jonas-schievink/thesis/meshes/kurt_wheel_outdoor.stl

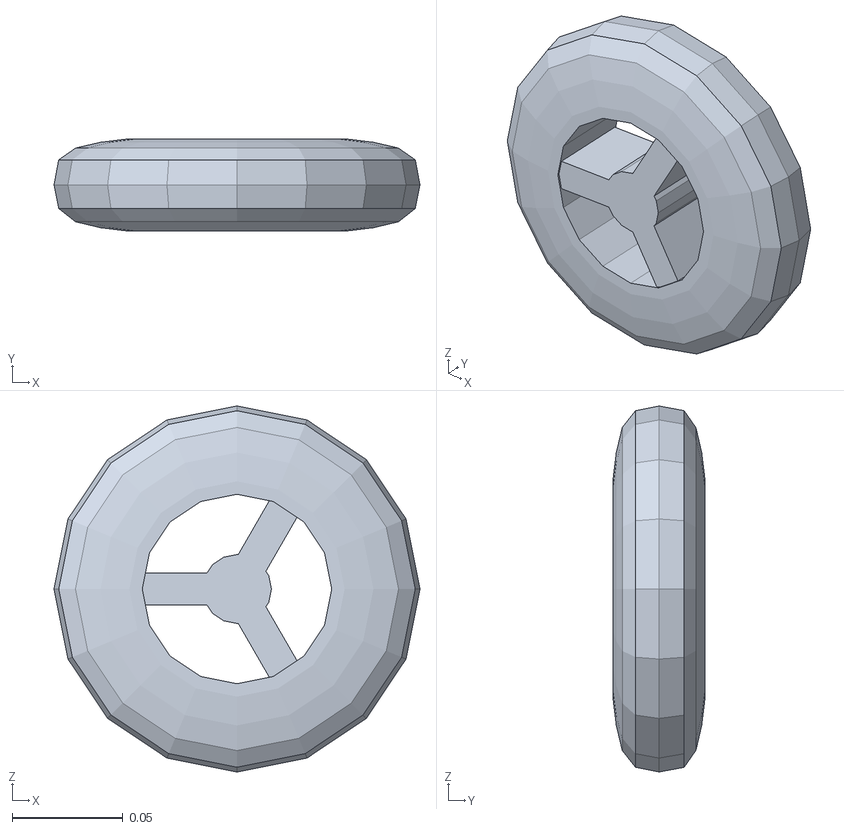
[picture p4: CAD file, 2018-02-05]
meshes/kurt_wheel_outdoor.stl
0.165 x 0.0417 x 0.165
