jonas-schievink/thesis/meshes/kurt_base_outdoor.stl

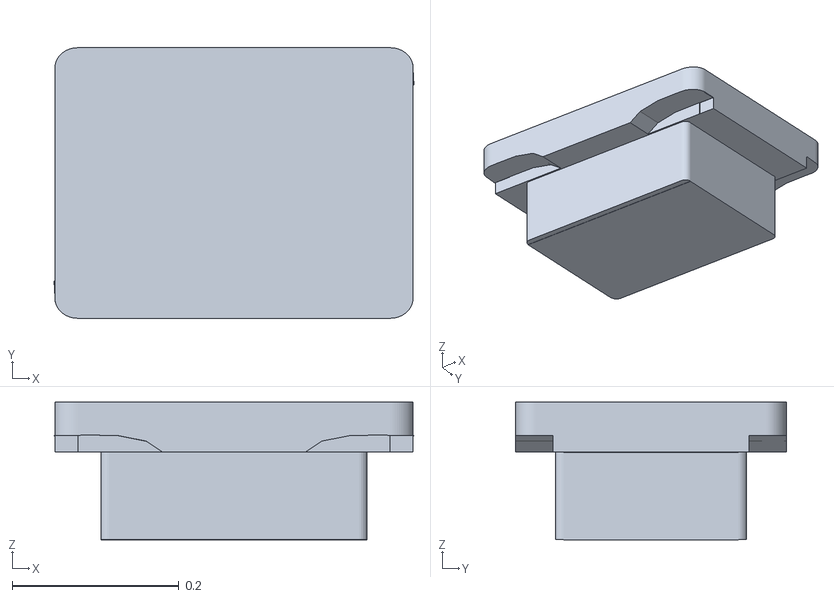
[picture p5: CAD file, 2018-02-05]
meshes/kurt_base_outdoor.stl
0.432 x 0.325 x 0.165
