jonas-schievink/thesis/meshes/kurt_wheel_indoor.stl

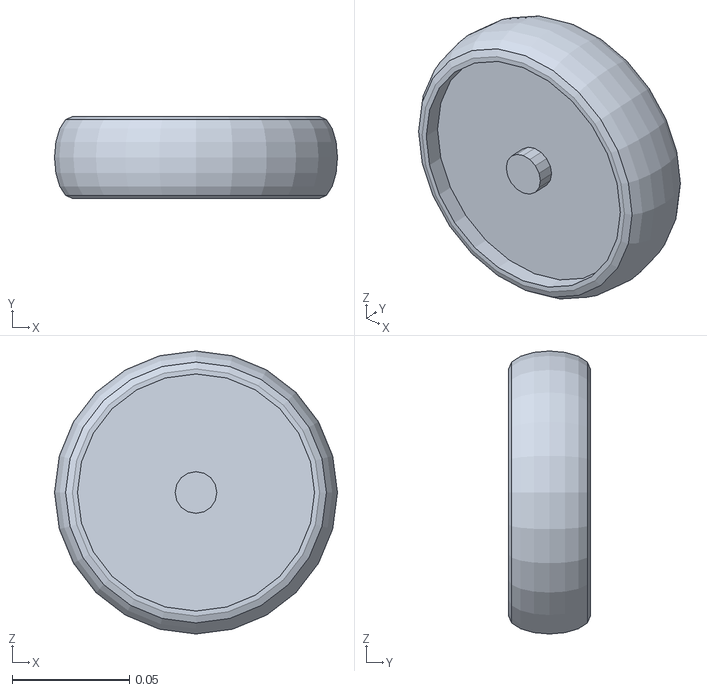
[picture p6: CAD file, 2018-02-05]
meshes/kurt_wheel_indoor.stl
0.121 x 0.0349 x 0.121
