jonas-schievink/thesis/meshes/kurt_base_indoor.stl

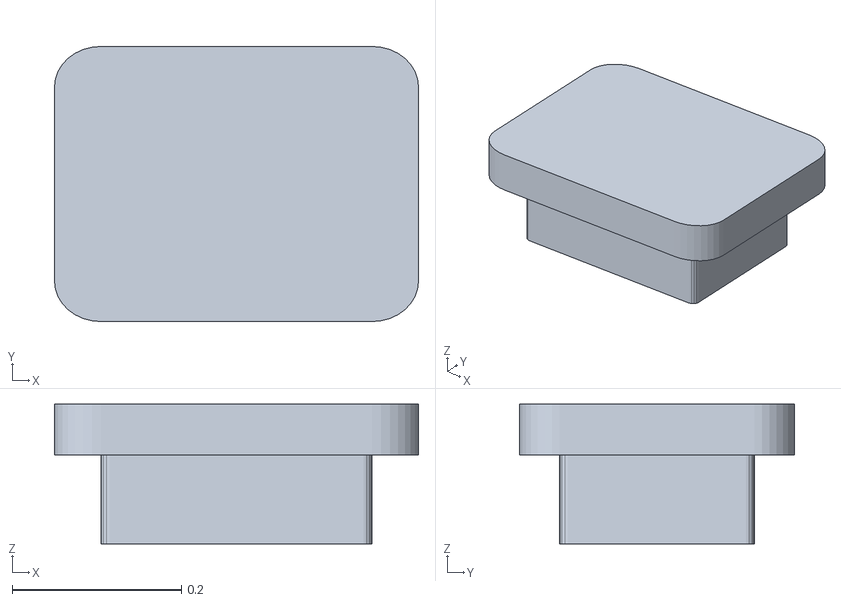
[picture p7: CAD file, 2018-02-05]
meshes/kurt_base_indoor.stl
0.43 x 0.325 x 0.165
