jonas-schievink/thesis/latex/kicad/electronics/electronics-cropped.pdf

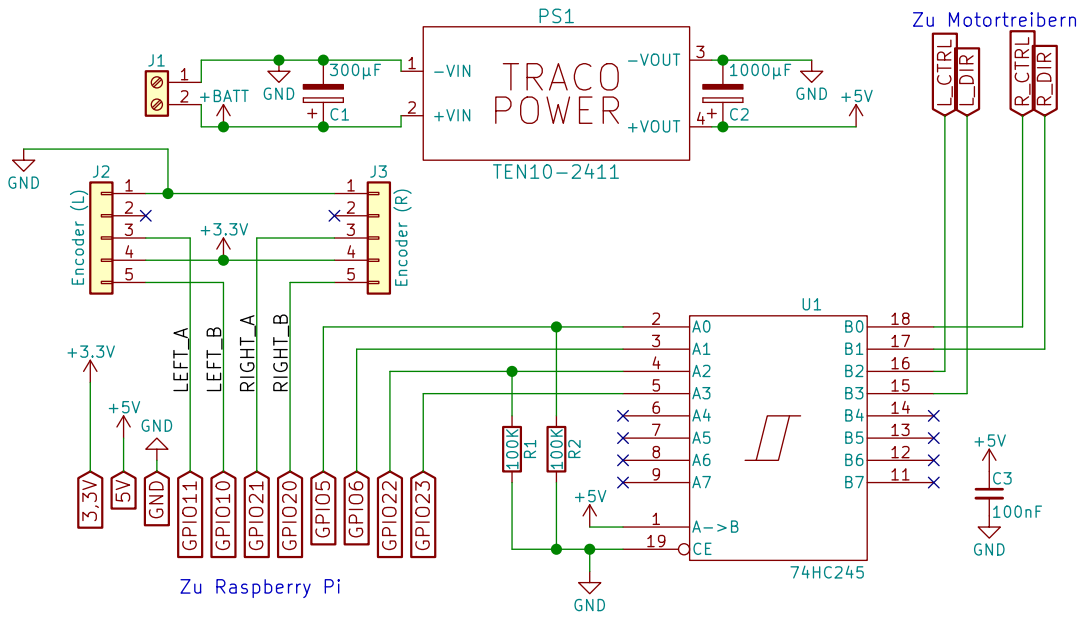
[picture p8: page 1]
