jonas-schievink/thesis/latex/kicad/electronics/electronics.pdf

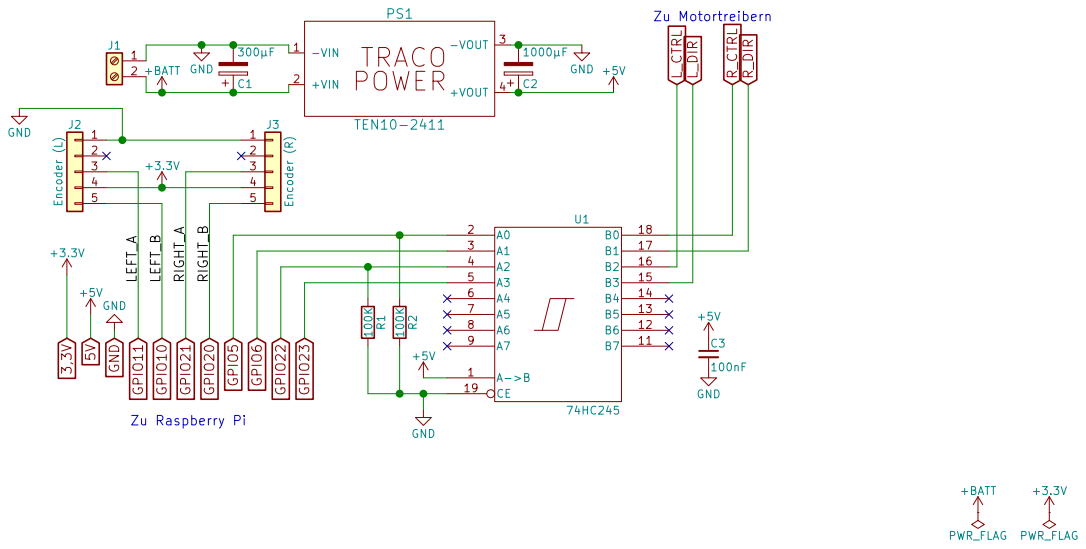
[picture p9: page 1]
