jonas-schievink/thesis/latex/kicad/h-bridge/h-bridge-cropped.pdf

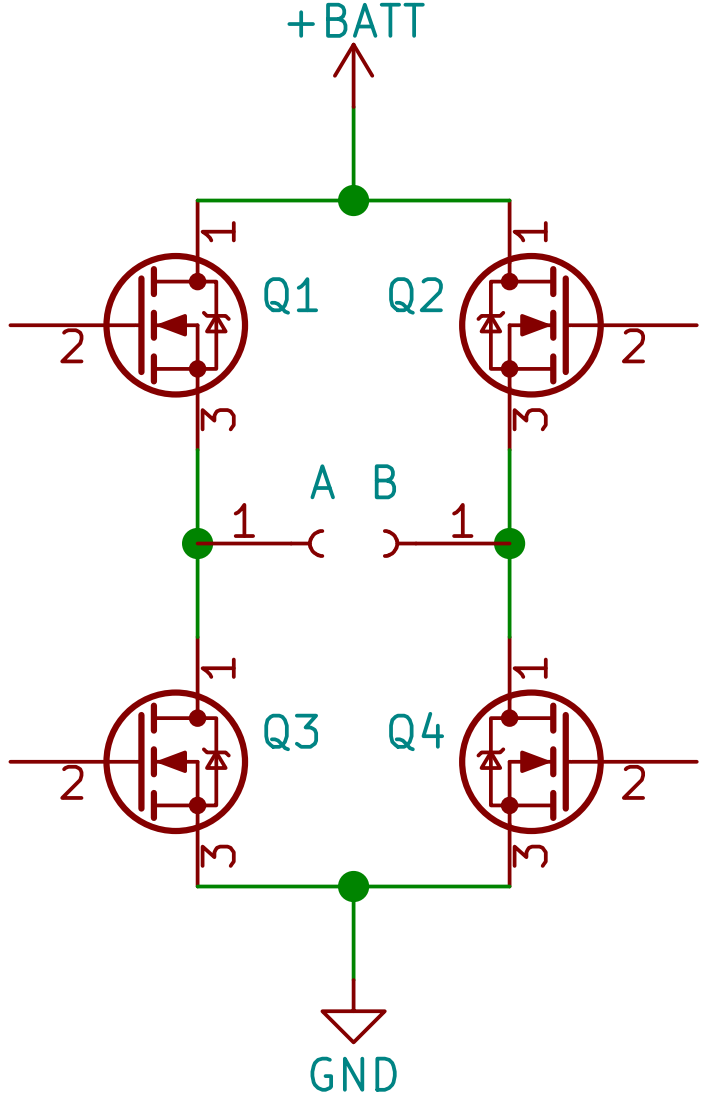
[picture p10: page 1]
