jonas-schievink/thesis/latex/kicad/h-bridge/h-bridge.pdf

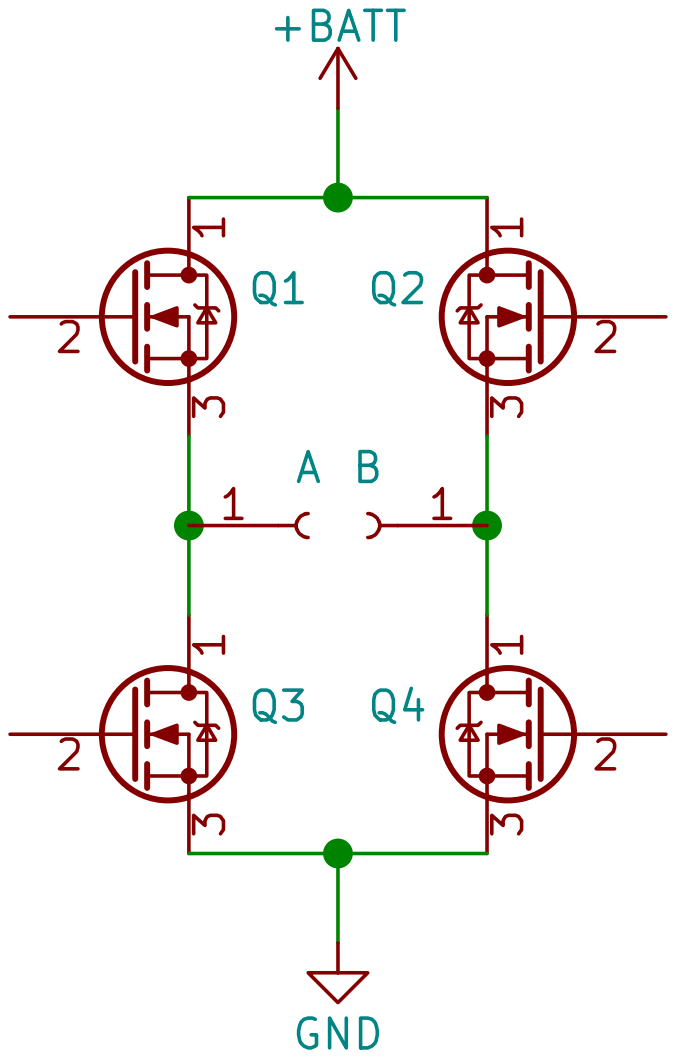
[picture p11: page 1]
