jonas-schievink/thesis/latex/kicad/motor-module/motor-module-cropped.pdf

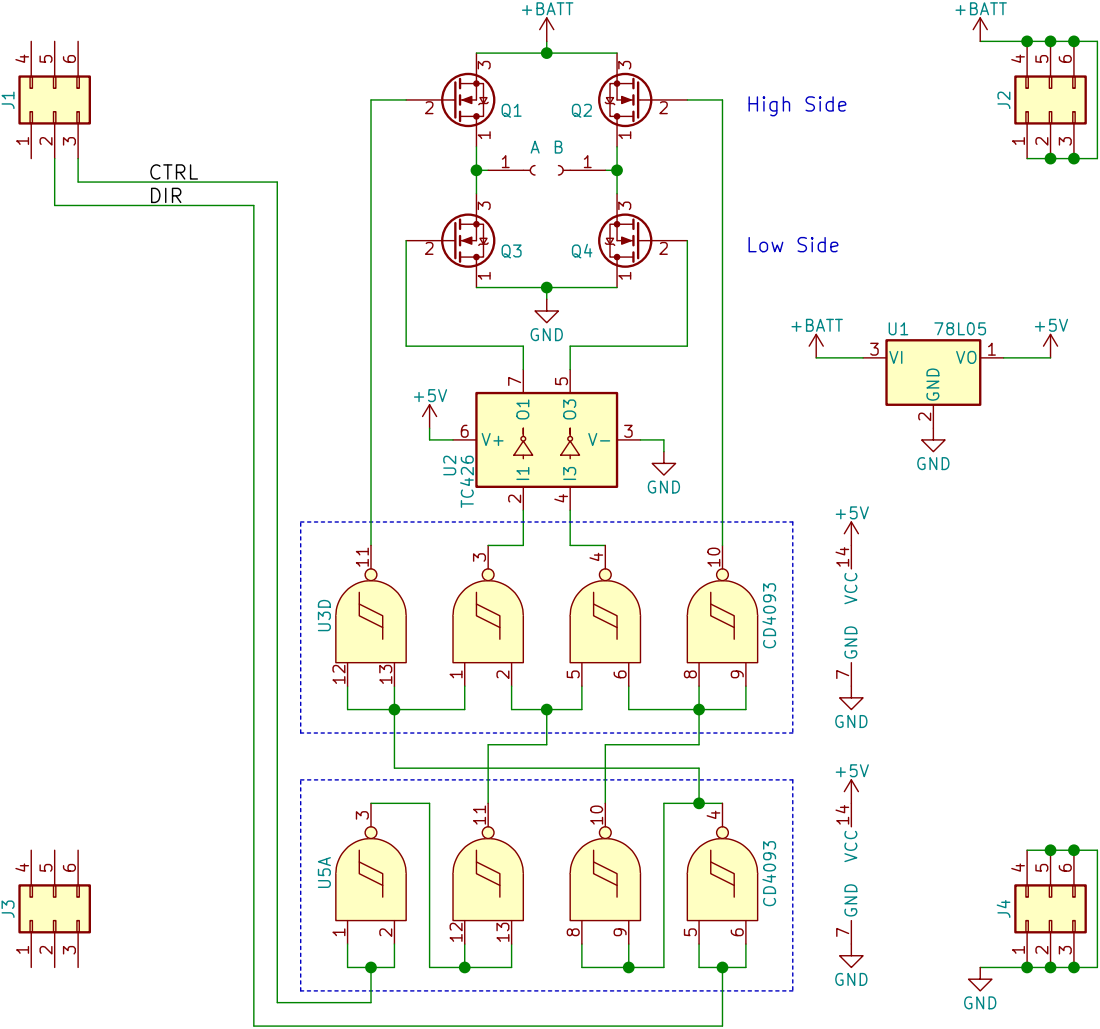
[picture p12: page 1]
