jonas-schievink/thesis/latex/kicad/motor-module/motor-module.pdf

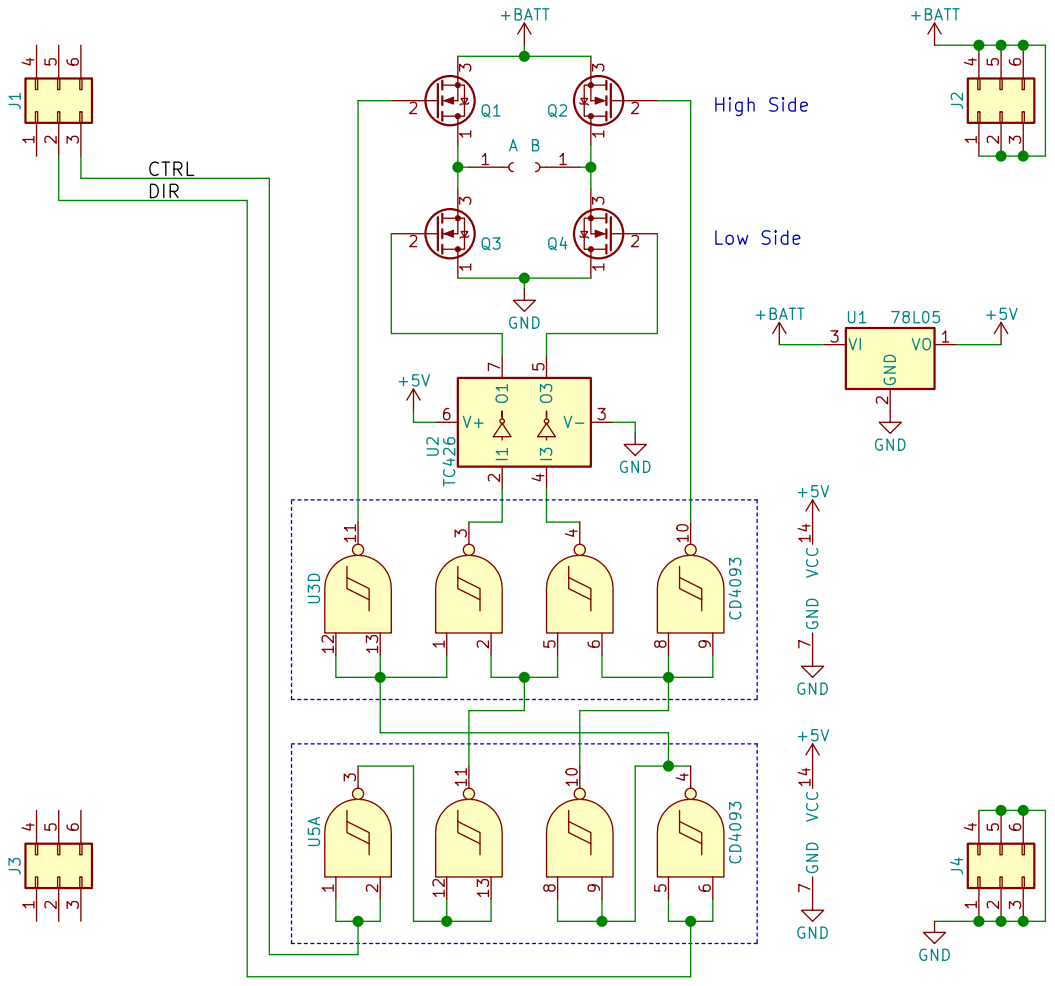
[picture p13: page 1]
