jonas-schievink/thesis/latex/kicad/electronics/electronics.sch

## KiCad design latex/kicad/electronics/electronics.sch (2019-05-02)

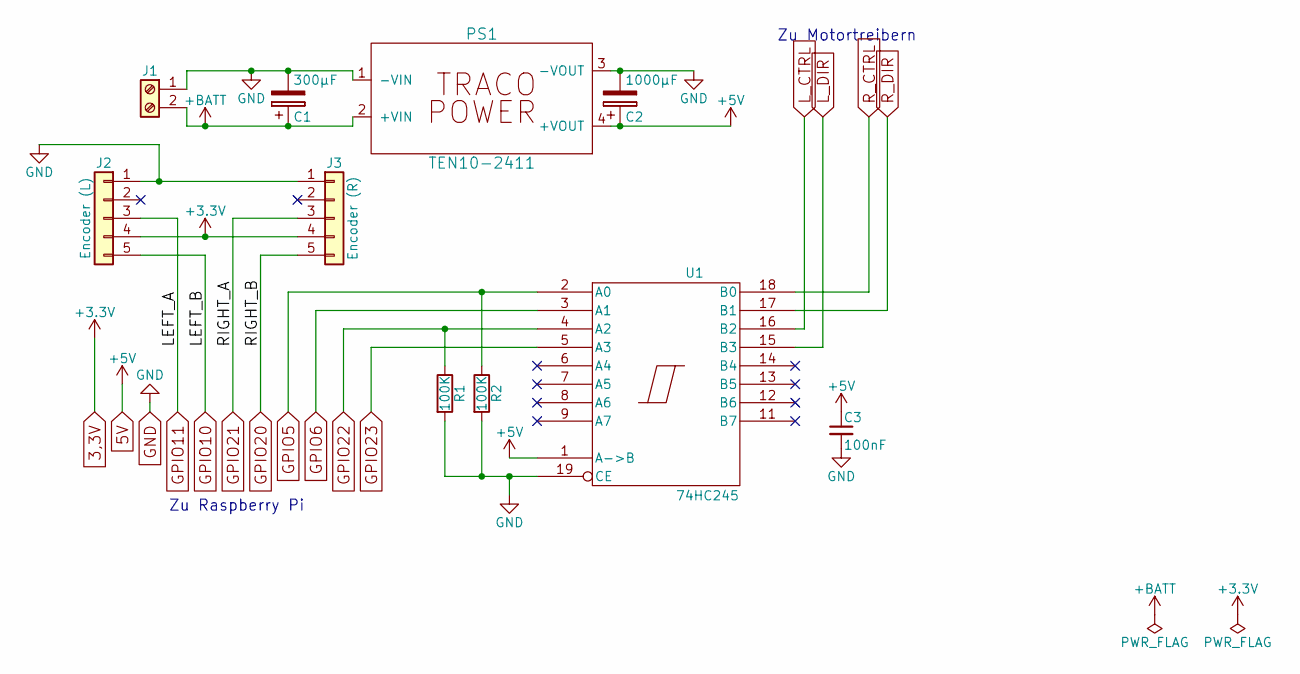
[picture p14: schematic electronics.sch]

Parts:
C1: 300µF
C2: 1000µF
C3: 100nF
J1: Battery Connector
J2: Encoder (L)
J3: Encoder (R)
PS1: TEN10-2411
R1, R2: 100K
U1: 74HC245; DIP-20_W7.62mm

Connections:
+3.3V: J2.4, J3.4
+5V: C2.1, C3.1, PS1.4 (+VOUT), U1.1 (A->B)
+BATT: C1.1, J1.2, PS1.2 (+VIN)
GND: C1.2, C2.2, C3.2, J1.1, J2.1, J3.1, PS1.1 (-VIN), PS1.3 (-VOUT), R1.2, R2.2, U1.19 (CE)
GPIO5: R2.1, U1.2 (A0)
GPIO6: U1.3 (A1)
GPIO10: J2.5
GPIO11: J2.3
GPIO20: J3.5
GPIO21: J3.3
GPIO22: R1.1, U1.4 (A2)
GPIO23: U1.5 (A3)
L_CTRL: U1.16 (B2)
L_DIR: U1.15 (B3)
R_CTRL: U1.18 (B0)
R_DIR: U1.17 (B1)

Notes on the sheet:
Zu Motortreibern
Zu Raspberry Pi
