jonas-schievink/thesis/latex/kicad/h-bridge/h-bridge.sch

## KiCad design latex/kicad/h-bridge/h-bridge.sch (2019-05-02)

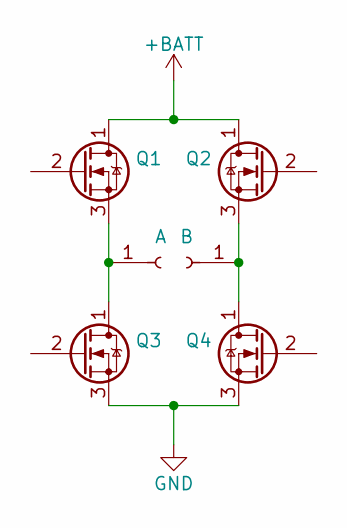
[picture p15: schematic h-bridge.sch]

Parts:
A: Conn_01x01_Female
B: Conn_01x01_Female
Q1, Q2, Q3, Q4: Q_NMOS_DGS

Connections:
+BATT: Q1.1 (D), Q2.1 (D)
GND: Q3.3 (S), Q4.3 (S)
unnamed: A.1, Q1.3 (S), Q3.1 (D)
unnamed: B.1, Q2.3 (S), Q4.1 (D)
