jonas-schievink/thesis/latex/kicad/motor-module/motor-module.sch

## KiCad design latex/kicad/motor-module/motor-module.sch (2019-05-02)

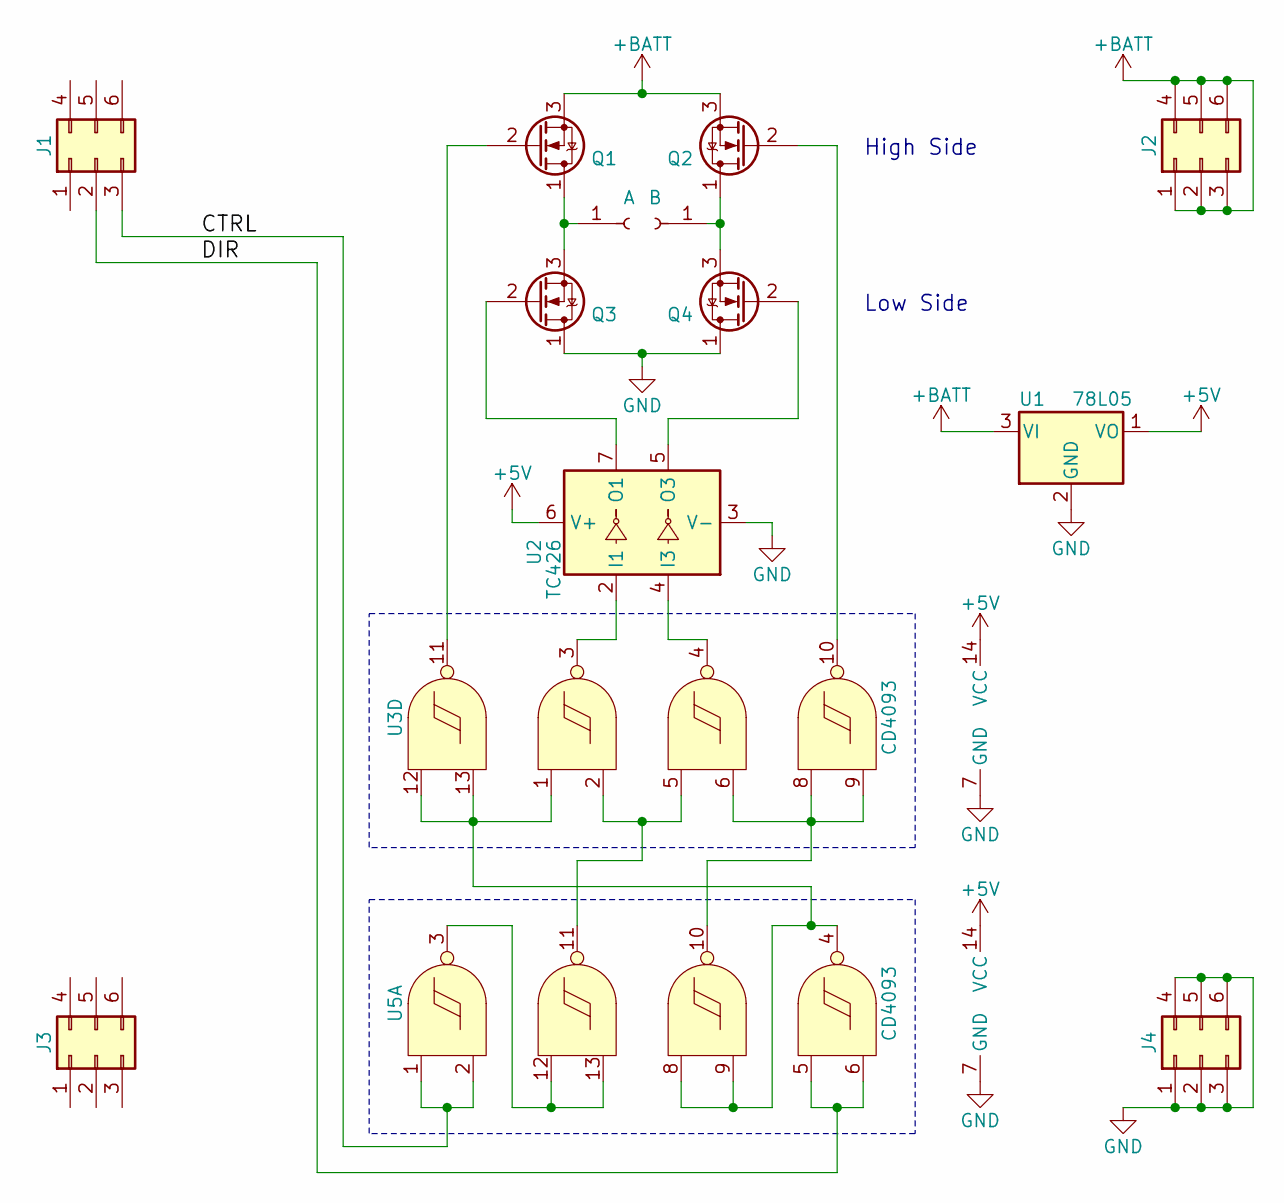
[picture p16: schematic motor-module.sch]

Parts:
A: Conn_01x01_Female
B: Conn_01x01_Female
J1, J2, J3, J4: Conn_02x03_Top_Bottom
Q1, Q2, Q3, Q4: Q_NMOS_DGS
U1: 78L05; TO-92_Inline_Narrow_Oval
U2: TC426
U3, U6: HEF4093B; SOIC-14_3.9x8.7mm_Pitch1.27mm
U4, U5: CD4093; SOIC-14_3.9x8.7mm_Pitch1.27mm

Connections:
+5V: U1.1 (VO), U2.6 (V+), U3.14 (VCC), U6.14 (VCC)
+BATT: J2.1, J2.2, J2.3, J2.4, J2.5, J2.6, Q1.3 (S), Q2.3 (S), U1.3 (VI)
CTRL: J1.3, U5.1, U5.2
DIR: J1.2, U4.5, U4.6
GND: J4.1, J4.2, J4.3, J4.4, J4.5, J4.6, Q3.1 (D), Q4.1 (D), U1.2 (GND), U2.3 (V-), U3.7 (GND), U6.7 (GND)
unnamed: A.1, Q1.1 (D), Q3.3 (S)
unnamed: B.1, Q2.1 (D), Q4.3 (S)
unnamed: Q1.2 (G), U3.11
unnamed: Q2.2 (G), U4.10
unnamed: Q3.2 (G), U2.7 (O1)
unnamed: Q4.2 (G), U2.5 (O3)
unnamed: U2.2 (I1), U4.3
unnamed: U2.4 (I3), U3.4
unnamed: U3.5, U4.2, U6.11
unnamed: U3.6, U4.8, U4.9, U5.10
unnamed: U3.12, U3.13, U4.1, U4.4, U5.8, U5.9
unnamed: U5.3, U6.12, U6.13

Notes on the sheet:
High Side
Low Side
