jonas-schievink/thesis/src/Motor.hpp

/**
 * @file Motor.hpp
 * @brief Provides the `Motor` class to control speed and direction of DC motors
 */

#ifndef MOTOR_HPP
#define MOTOR_HPP

#include <ros/time.h>
#include "PiGPIO.hpp"


struct MotorConfig {
    /**
     * @brief GPIO for enabling the motor (HIGH=On, LOW=Off).
     */
    int ctrl_pin;
    /**
     * @brief GPIO for changing motor directions (HIGH=Reverse, LOW=Normal).
     */
    int direction_pin;
    /**
     * @brief PWM frequency to request.
     *
     * This is just a *hint* and may not be obeyed. The real frequency will be
     * logged to the console.
     */
    int pwm_freq;
    /**
     * @brief PWM value range to request.
     *
     * This is just a *hint* and may not be obeyed. The real range will be
     * logged to the console.
     */
    int pwm_range;
    /**
     * @brief Abs. limit on the delta time between `Motor::update` calls.
     *
     * This ensures that a big time delta (due to bugs / hiccups elsewhere)
     * doesn't cause us to apply a big PWM signal difference in one step.
     */
    int max_delta_ms;
    /**
     * @brief Max. acceleration in vel%/s.
     */
    float max_accel;
    /**
     * @brief Max. number of direction changes per second.
     */
    float max_dir_changes;
    /**
     * @brief Speed values of up to this magnitude are clamped to 0.
     *
     * This is useful to get rid of the coil whining when the motors aren't
     * actually turning because the speed value is too low.
     */
    float deadzone;
    /**
     * @brief Invert the motor direction.
     */
    bool invert;

    MotorConfig(int ctrl_pin, int dir_pin);
};

/**
 * @brief Controls speed and direction of a single motor using GPIOs.
 *
 * This class does *not* perform PID speed control, it represents an additional
 * layer of protection which prevents overly rapid acceleration and other
 * stressful operations for the robot hardware.
 */
class Motor {
    pigpio::Pin m_speed_pin;
    pigpio::Pin m_dir_pin;
    MotorConfig m_config;
    /// @brief Target speed, always in range [-1.0, 1.0]
    float m_setpoint;
    /// @brief Actual speed, always in range [-1.0, 1.0]
    float m_actual;
    /// @brief Delay in seconds between direction changes.
    float m_dirChangeDelay;
    /// @brief Time of the last update or construction.
    ros::Time m_lastUpdate;
    /// @brief Last change of direction (of @ref m_dir_pin).
    ros::Time m_lastDirChange;
    bool m_firstUpdate;
    int m_pwmRange;

    /**
     * @brief Set motor speed without safety checks.
     * @param speed Motor speed in range -1...1
     *
     * This will set @ref m_actual to @ref speed and configure the GPIOs to
     * drive the motor at the configured speed.
     */
    void setDirect(float speed, bool dryrun);

    /**
     * @brief Attempt to set motor direction to @ref dir
     * @return `true` if successful, `false` if the limit was hit
     */
    bool setDirection(bool dir);

public:
    Motor(MotorConfig config);

    /**
     * @brief Sets the target speed and direction of the motor
     * @param speed Speed of the motor as a float in range [-1.0, 1.0]
     *
     * If @ref speed parameter is negative, the motor will move backwards.
     * Otherwise, it will move forwards.
     */
    void set(float speed);

    /**
     * @brief Must be called in regular intervals to update the motor speed
     */
    void update(bool dryrun);

    /**
     * @brief Whether the motor has reached its set point.
     *
     * Note that this only concerns the software protection features. It does
     * not guarantee that the motor actually runs at some defined speed.
     */
    bool reachedSetPoint() const;
};

#endif  // MOTOR_HPP
