jonas-schievink/thesis/src/EvdevEncoder.hpp

#ifndef EVDEVENCODER_HPP
#define EVDEVENCODER_HPP

#include "Encoder.hpp"

#include <libevdev/libevdev.h>

#include <string>
#include <stdexcept>

/**
 * @brief Exception thrown when an `EvdevEncoder` can not find a matching input
 * device.
 */
class EvdevException : public std::runtime_error {
public:
    EvdevException(const std::string& what);
};

/**
 * @brief A rotary encoder evdev
 *
 * This can be used to attach a Linux rotary-encoder device. The device must be
 * configured to report events using the ABS_X axis (absolute axis).
 */
class EvdevEncoder : public Encoder {
    struct libevdev* m_evdev;
    int m_lastCount;
    int m_wrap;
    bool m_invert;

public:
    /**
     * @brief Create a new evdev encoder by searching for an input device
     * @param search_name Device name the encoder has to match
     * @param wrap Number of steps after which the reported value wraps
     * @param invert Whether to invert the direction
     *
     * This will search all `/dev/input/event*` devices for an input device
     * whose name matches `search_name`.
     *
     * To figure out the device name, the `evtest` tool can be used.
     *
     * If no or more than 1 device matches the name, an `EvdevException`
     * will be thrown.
     *
     * The @ref wrap parameter must be kept in-sync with the device tree
     * overlay.
     */
    EvdevEncoder(int ticksPerTurn, const std::string& search_name, int wrap, bool invert = false);

    ~EvdevEncoder();

protected:
    int read() override;
};

#endif // EVDEVENCODER_HPP
