jonas-schievink/thesis/(commit log)

2017-11-17 Initial commit
    Encoder reading works and displays a nice slider.
    Motor stuff is untested
2017-12-18 WIP devicetree
2017-12-19 Get the device tree to work
2018-01-23 encoders.dts cleanup
2018-01-23 swap left and right encoders
    turns out I've got KURTs sides backwards :)
2018-01-23 Rename Encoder class
2018-01-25 open evdev encoders
2018-01-26 read encoder events
2018-01-26 Finish encoder implementation
2018-01-29 Encoder -> RawEncoder
2018-01-29 work on motor
2018-01-30 better motor configuration code
2018-01-31 convert cmd_vel msgs to wheel setpoints
2018-02-01 Proper encoder conversion
2018-02-01 Encoder speed calculation
2018-02-01 Prepare odometry for actual odometry calculation
2018-02-02 Publish joint state and odom
2018-02-05 import and use urdf/meshes
    [infrared_sonar.urdf.xacro, kurt_base_indoor.stl, kurt_base_outdoor.stl, kurt_indoor.urdf.xacro, kurt_outdoor.urdf.xacro, kurt_wheel_indoor.stl, kurt_wheel_outdoor.stl, rotunit.urdf.xacro]
2018-02-05 rename outdoor kurt_base refs, too
    [kurt_outdoor.urdf.xacro]
2018-02-06 utilize ros_control and pid
2018-02-07 only change motor direction if speed is not ~0.0
2018-02-07 debuggable motor, temp. import of odometry
2018-02-08 fix relay name, windup limit
2018-02-08 fix dryrun param, add notice
    [Kurt.cpp]
2018-02-08 support evdev in encoder.py
2018-02-08 saner motor speed
2018-02-08 automatically determine max encoder value
2018-02-24 device-tree: increase encoder steps until rollover
2018-02-24 motor.py: set default PWM freq to 1000 Hz
2018-02-24 motor: re-add update computations
2018-02-24 motor: use ros time, various fixes
    [Motor.cpp, Motor.hpp]
2018-02-24 fix calculation of new speed
    [Motor.cpp]
2018-02-28 swap L/R pin defaults
    [Kurt.cpp]
2018-02-28 begin PID tuning (this oscillates extremely)
2018-03-19 update readme to reflect current workflow and IP config
2018-03-19 fix wheel radius
    was slightly off, just by a factor of 3
2018-03-19 pass PID args to Kurt
    unused, but the plan is to implement PID in the Kurt node
2018-03-21 PID, not PI
    The original code used a PD controller, and according to my research,
    that's much more suitable for this kind of control work.
    Just go ahead and implement the full PID controller.
2018-03-21 Slight PID tuning
2018-03-21 More conservative max. motor acceleration
2018-03-22 make pid params mandatory
2018-03-22 log matched evdev encoders
2018-03-22 more useful PID config logging
2018-03-23 motor inversion
2018-03-23 log right motor
2018-03-23 pid update docs
2018-03-23 cmd[1] for right wheel
2018-06-19 Bump update rate from 20 to 100 Hz and clean up its logic
2018-06-19 Make all node parameters mandatory to avoid errors
    [Kurt.cpp, Kurt.hpp, Main.cpp]
2018-06-19 allow configuring pigpio's sample rate
    and more signal handler nonsense
2018-06-21 Increase PWM range and node priority
2018-06-21 fix doc formatting and increase PWM freq slightly
2018-06-21 encoder.py: print counts per second
2018-06-21 only log errors when missing 3 updates in a row
    [Main.cpp]
2018-06-21 remove obsolete odometry class and publish joint states for all wheels
2018-06-21 fix rear wheel joint names
    [Kurt.cpp]
2018-06-26 add comment to the motor update warning
2018-06-27 free opened evdev devices on errors and mismatch
    [EvdevEncoder.cpp]
2018-06-29 plotodom.py: print currently sent speed
2018-06-29 draw.py: fix handling of 1x1 graphs
    [draw.py]
2018-06-29 adjust pwm freq and PID params
2019-05-02 Add LaTeX and KiCad sources
    [electronics.kicad_pcb, electronics.sch, h-bridge.kicad_pcb, h-bridge.sch, motor-module.kicad_pcb, motor-module.sch, pi-header.kicad_pcb, pi-header.sch]
